francc/luminch-one/luminch_one_breadboard.png

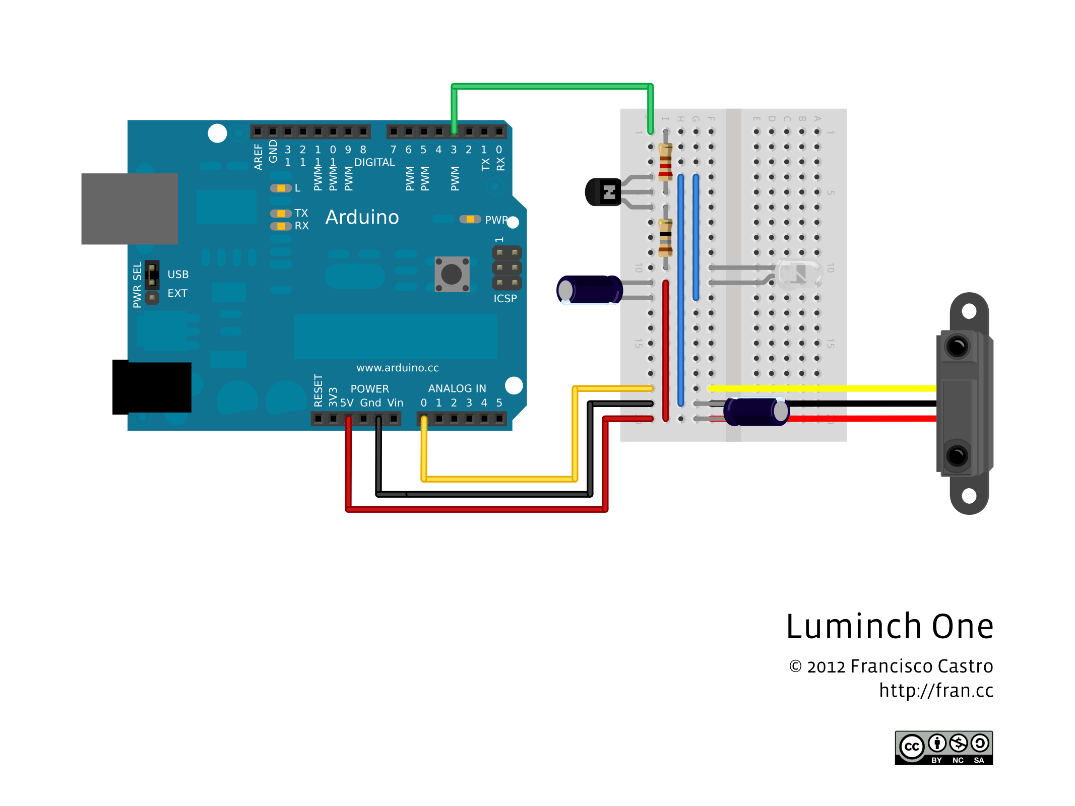
luminch_one_breadboard.png
