francc/luminch-one/luminch_one_schematic.png

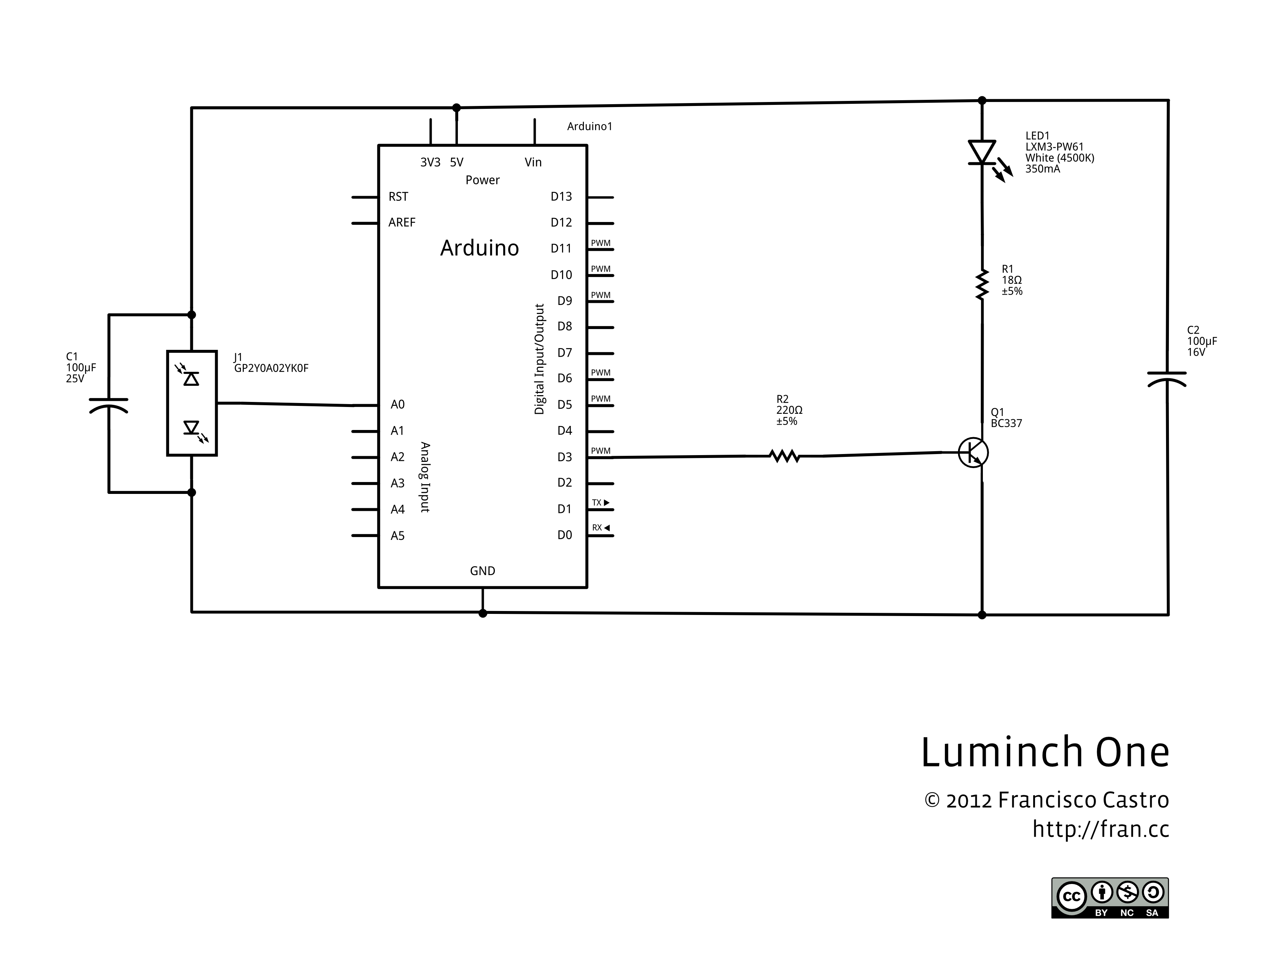
luminch_one_schematic.png
