francc/luminch-one/(list of files, drawings)

Other design files:
luminch_one.fz
