francc/luminch-one/luminch_one_tutorial.pdf

# Luminch One

Author: Francisco Castro

Tools used in this project Cutting mat (http://makeprojects.com/Item/Cutting_mat) (1)
Hobby knife (http://makeprojects.com/Item/Hobby_knife) (1)
Hot-glue gun (http://makeprojects.com/Item/Hot-glue_gun) (1)
Masking tape (http://makeprojects.com/Item/Masking_tape) (1)
Pencil (http://makeprojects.com/Item/Pencil) (1)
Rule (http://makeprojects.com/Item/Rule) (1)
Soldering iron (http://makeprojects.com/Item/Soldering_iron) (1)
Swiss Army knife (http://makeprojects.com/Item/Swiss_Army_knife) (1)
White glue (http://makeprojects.com/Item/White_glue) (1)

Parts relevant to this project
Infrared Proximity Sensor Long Range - Sharp GP2Y0A02YK0F (http://makeprojects.com/Item/Infrared_Proximity_Sensor_Long_Range_-_Sharp_GP2Y0A02YK0F) (1) Infrared Sensor Jumper Wire - 3-Pin JST (http://makeprojects.com/Item/Infrared_Sensor_Jumper_Wire_-_3-Pin_JST) (1)
Arduino Uno (http://makeprojects.com/Item/Arduino_Uno) (1)
Breadboard Mini Self-Adhesive (http://makeprojects.com/Item/Breadboard_Mini_Self-Adhesive) (1)
Electrolytic Decoupling Capacitor - 100uF/25V (http://makeprojects.com/Item/Electrolytic_Decoupling_Capacitor_-_100uF_25V) (2)
Jumper Wires Premium 6" M/M Pack of 10 (http://makeprojects.com/Item/Jumper_Wires_Premium_6%22_M_M_Pack_of_10) (1)
Luxeon Rebel High Power LED Breakout - Warm White (http://makeprojects.com/Item/Luxeon_Rebel_High_Power_LED_Breakout_-_Warm_White) (1) Break Away Male Headers - Right Angle (http://makeprojects.com/Item/Break_Away_Male_Headers_-_Right_Angle) (1)
USB Cable A to B - 6 Foot (http://makeprojects.com/Item/USB_Cable_A_to_B_-_6_Foot) (1)
Wall Charger - 5V USB (http://makeprojects.com/Item/Wall_Charger_-_5V_USB) (1)
Resistor 18 ohms 1W (http://makeprojects.com/Item/Resistor_18_ohms_1W) (1)
Resistor 220 ohms 1/4W (http://makeprojects.com/Item/Resistor_220_ohms_1_4W) (1)
NPN Transistor BC337 (http://makeprojects.com/Item/NPN_Transistor_BC337) (1)
Short jumper wires (like the conductors from solid core UTP cable) (http://makeprojects.com/Item/Short_jumper_wires_%28like_the_conductors_from_solid_core_UTP_cable%29) (1) Heat shrink 3mm diameter (1/8 inch) (http://makeprojects.com/Item/Heat_shrink_3mm_diameter_%281_8_inch%29) (1)
Balsa Wood Sheet 36" x 3/16" x 3" (http://makeprojects.com/Item/Balsa_Wood_Sheet_36%22_x_3_16%22_x_3%22) (1)
Tracing Paper Sheet A4 110 to 200 gsm (http://makeprojects.com/Item/Tracing_Paper_Sheet_A4_110_to_200_gsm) (1)

Luminch One is an interactive lamp controlled by the movements of your hand. Wave your hand over it to turn it on or off, or move your hand up or down above it to change its brightness. Inside the lamp, an Arduino hooked to an infrared distance sensor tracks your hand and sets the state and the brightness of the LED lamp.

### Luminch One

© Make Projects | www.makeprojects.com | Page 1 of 6

Step 1 — Get the tools and materials

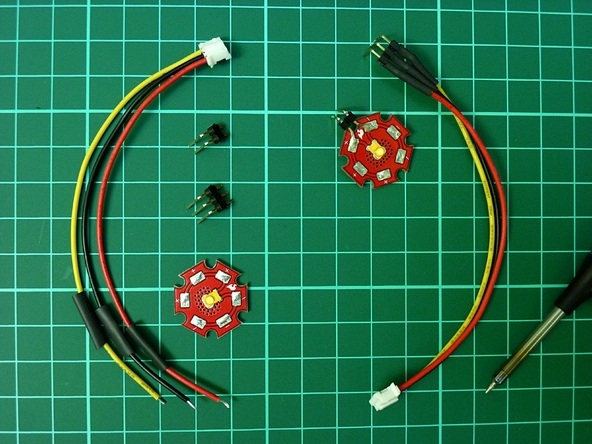
[picture p3: figure]

Step 2 — Solder the connectors

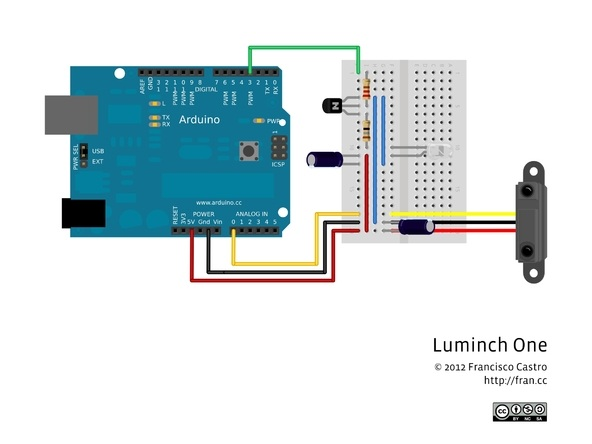
[picture p4: figure]

Step 3 — Assemble the circuit

You can get most of the electronic parts required for this project from Sparkfun. (http://www.sparkfun.com) Click the items from the parts list to go to the product page of each part.

Cut a 2-pin piece from the right-angle header strip and solder it to the LED board.
Cut a 3-pin piece from the right-angle header strip and solder it to the infrared sensor cable following the color order in the picture. You can add heat-shrink tubing to the wires before soldering them.

Assemble the circuit on the protoboard following the picture and the schematic. Pay attention to the polarity of the electrolytic capacitors and the transistor.

Step 4 — Program the Arduino

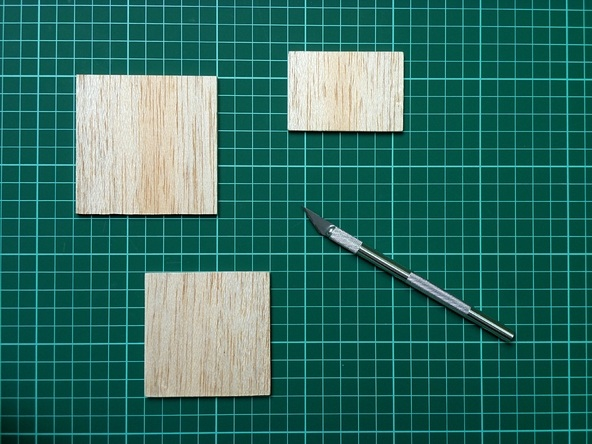
[picture p5: figure]

Step 5 — Cut the balsa sheet

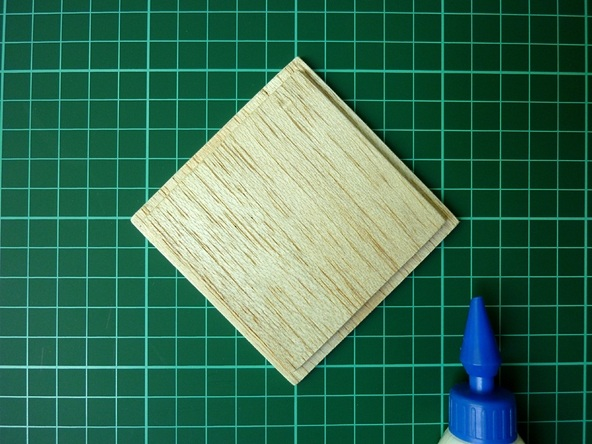
[picture p6: figure]

Step 6 — Glue the base

Connect the Arduino to your computer using the USB cable.
Download the source code (https://fran-cc-blog.s3.amazonaws.com/luminch_one.zip) for the project.
Start the Arduino IDE and open the luminch_one.ino file.
Configure the board type and serial port for your Arduino in the IDE.
Upload the code to the Arduino.
Test if it works!

Cut three pieces of balsa wood of the following sizes: 77 mm x 77 mm, 70 mm x 70 mm, and 45 mm x 65 mm.

Glue the 70x70 mm balsa square on the center of the 77x77 mm balsa square using the white glue. Let it dry for two or three hours under a heavy object like a large book.

Step 7 — Glue the Arduino

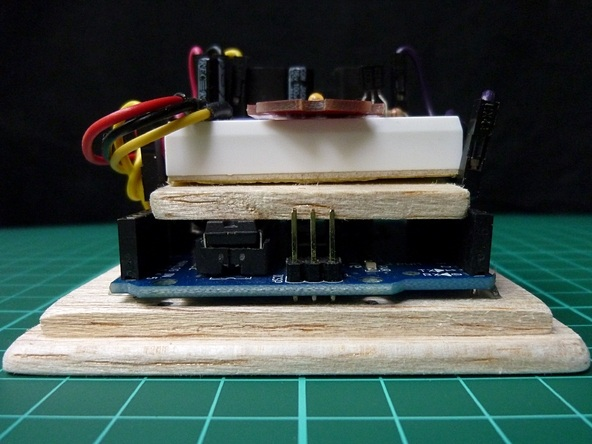
[picture p7: figure]

Step 8 — Stack the circuits

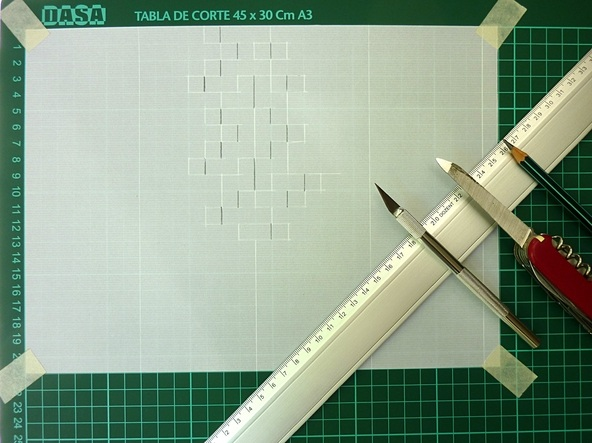
[picture p8: figure]

Step 9 — Cut and score the lampshade

Glue the Arduino on the center of the wood base using the hot-glue gun. Make sure the board of the Arduino does not stick out of the small square of the base. Only the USB connector of the Arduino must stick out of the small square.

Glue the protoboard and the infrared sensor to the 45x65 mm balsa piece.
Put the 45x65 mm balsa piece on the top of the Arduino and fold the cables on the sides.

Print the luminch_one_lampshade.pdf file from the project files (https://fran-cc-blog.s3.amazonaws.com/luminch_one.zip) on the A4 tracing paper sheet.
Fix the A4 tracing paper sheet to the cutting mat using the masking tape.
Cut the solid lines of the pattern using the hobby knife.
Score the dashed lines with the point of the file tool of the Swiss Army knife or with another paper scoring tool.
Remove the sheet from the cutting mat.
Score the dot-dashed lines on the back side of the sheet with the point of the file tool of the Swiss Army knife or with another paper scoring tool.

Step 10 — Fold and glue the lampshade

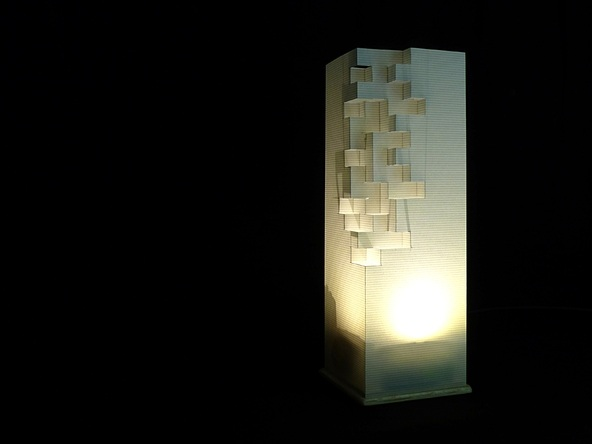
[picture p9: figure]

Step 11 — Assemble the lamp

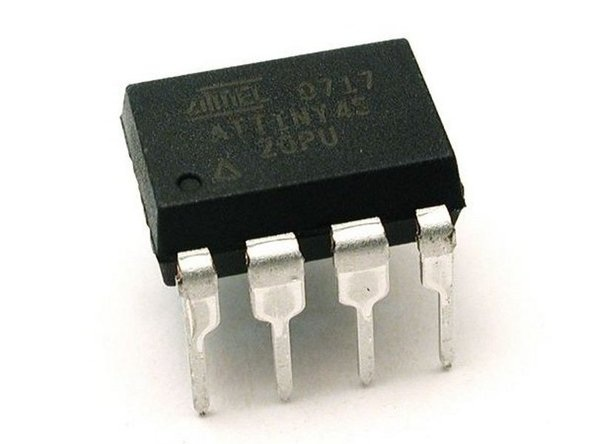
[picture p10: figure]

Step 12 — Further improvements

Fold the sheet following the dashed and dot-dashed lines. Dashed lines are valleys and dot-dashed lines are mountains.
Glue the flap to shape the lampshade as a square prism.
Cut a square hole for the USB connector of the Arduino.

Put the lampshade on the wood base.
Connect one end of the USB cable to the Arduino. Connect the other end of the USB cable to the USB wall charger.
Plug the USB wall charger into a power outlet. Enjoy! :)

Replace the Arduino with an ATtiny45 or ATtiny85 to reduce the size of the circuits.
Attach a heat sink to the LED and replace its resistor by a smaller one (6.8 to 10 ohms) to increase the LED power.
Replace the hot-glue with screws to ease disassembly at the unit's end-of-life.

Step 13 — End-of-life disassembly

This document was last generated on Feb 23, 2012.

Remove the circuits and the hot-glue from the balsa wood pieces.
Cut the lampshade and the balsa wood in small pieces and compost them in your garden. Disassembly the circuits by removing the cables and the components from the protoboard.
Reuse the Arduino and the electronic components in another fun project!
